eugeneworldwide/rampage_navigation_controller/Images/Additional Images/1650273794361.jpg

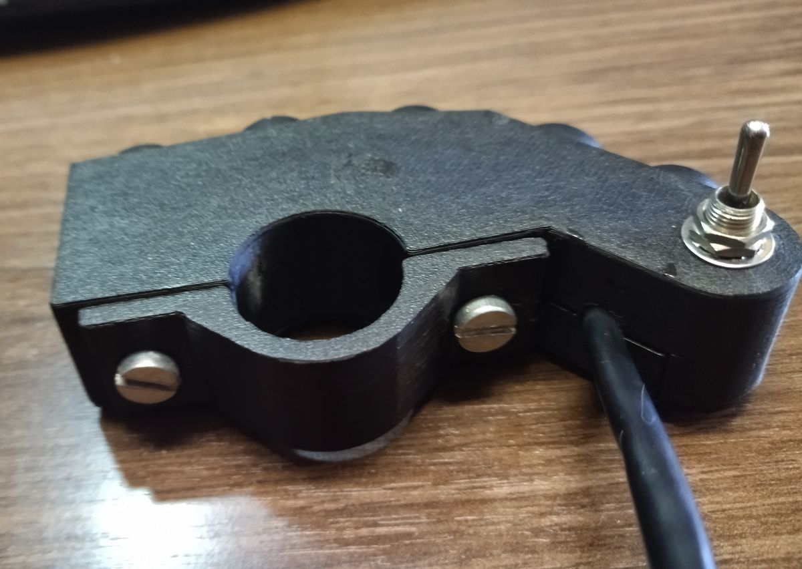
Images/Additional Images/1650273794361.jpg
