eugeneworldwide/rampage_navigation_controller/3D Print files/Bluetooth Controller v1.3 ORIGINAL SOLID DESIGN/Box Design.pdf

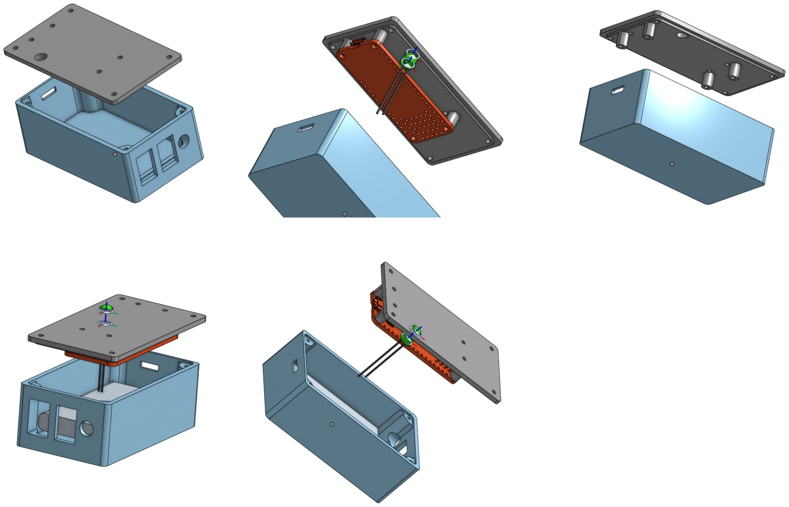
[picture p3: page 1]
