eugeneworldwide/rampage_navigation_controller/3D Print files/Bluetooth Controller v1.3 ORIGINAL SOLID DESIGN/Button Design.pdf

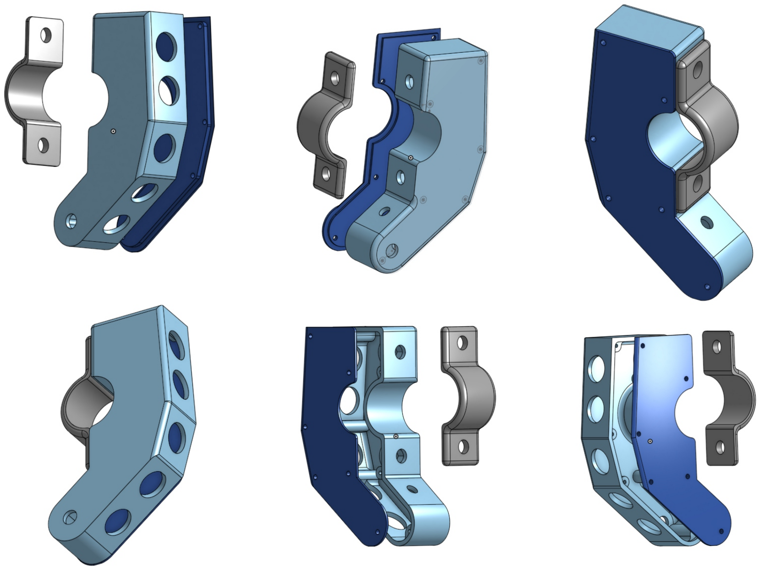
[picture p4: page 1]
