eugeneworldwide/rampage_navigation_controller/Circuit Design with 3 power options/01 Rampage Nav Circuit Design with battery.jpg

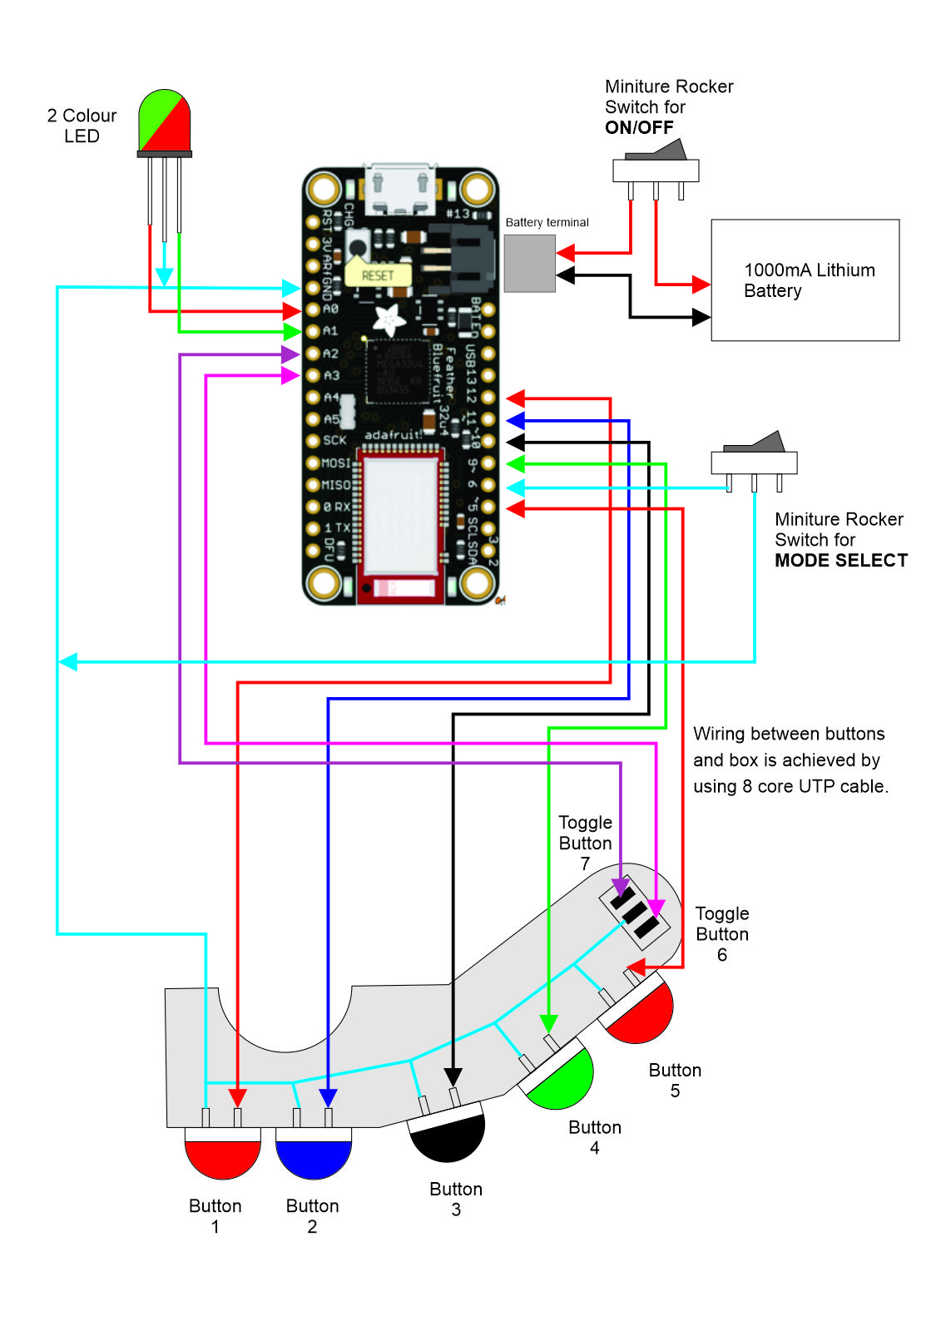
Circuit Design with 3 power options/01 Rampage Nav Circuit Design with battery.jpg
