eugeneworldwide/rampage_navigation_controller/Circuit Design with 3 power options/02 Rampage Nav Circuit Design with permanant power & battery backup.jpg

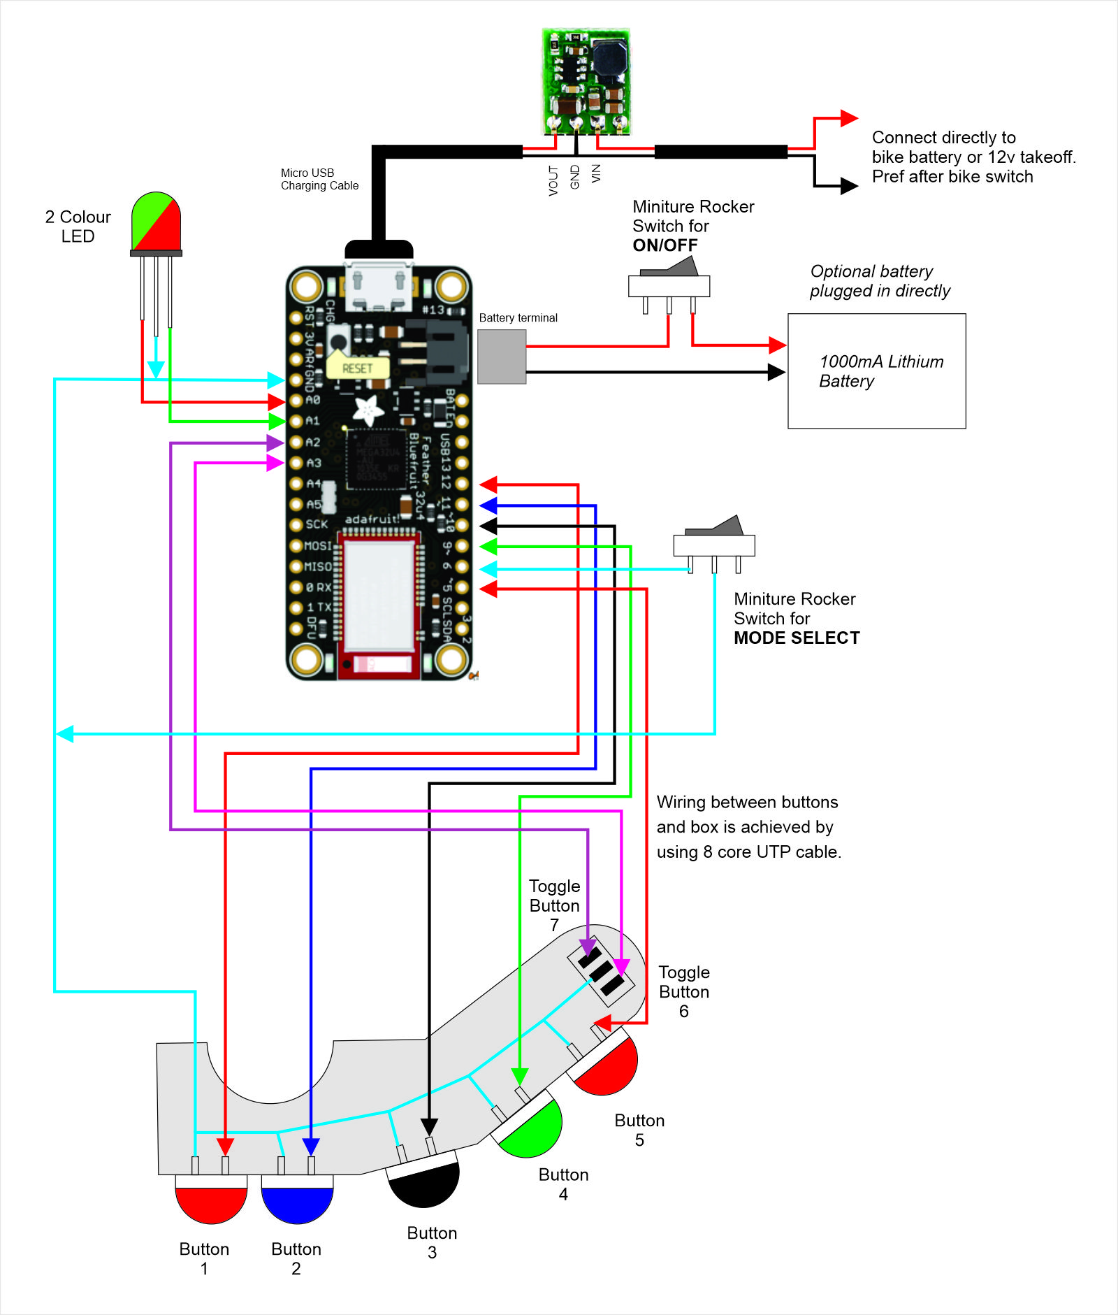
Circuit Design with 3 power options/02 Rampage Nav Circuit Design with permanant power & battery backup.jpg
