eugeneworldwide/rampage_navigation_controller/Circuit Design with 3 power options/03 Rampage Nav Circuit Design with permanant power.jpg

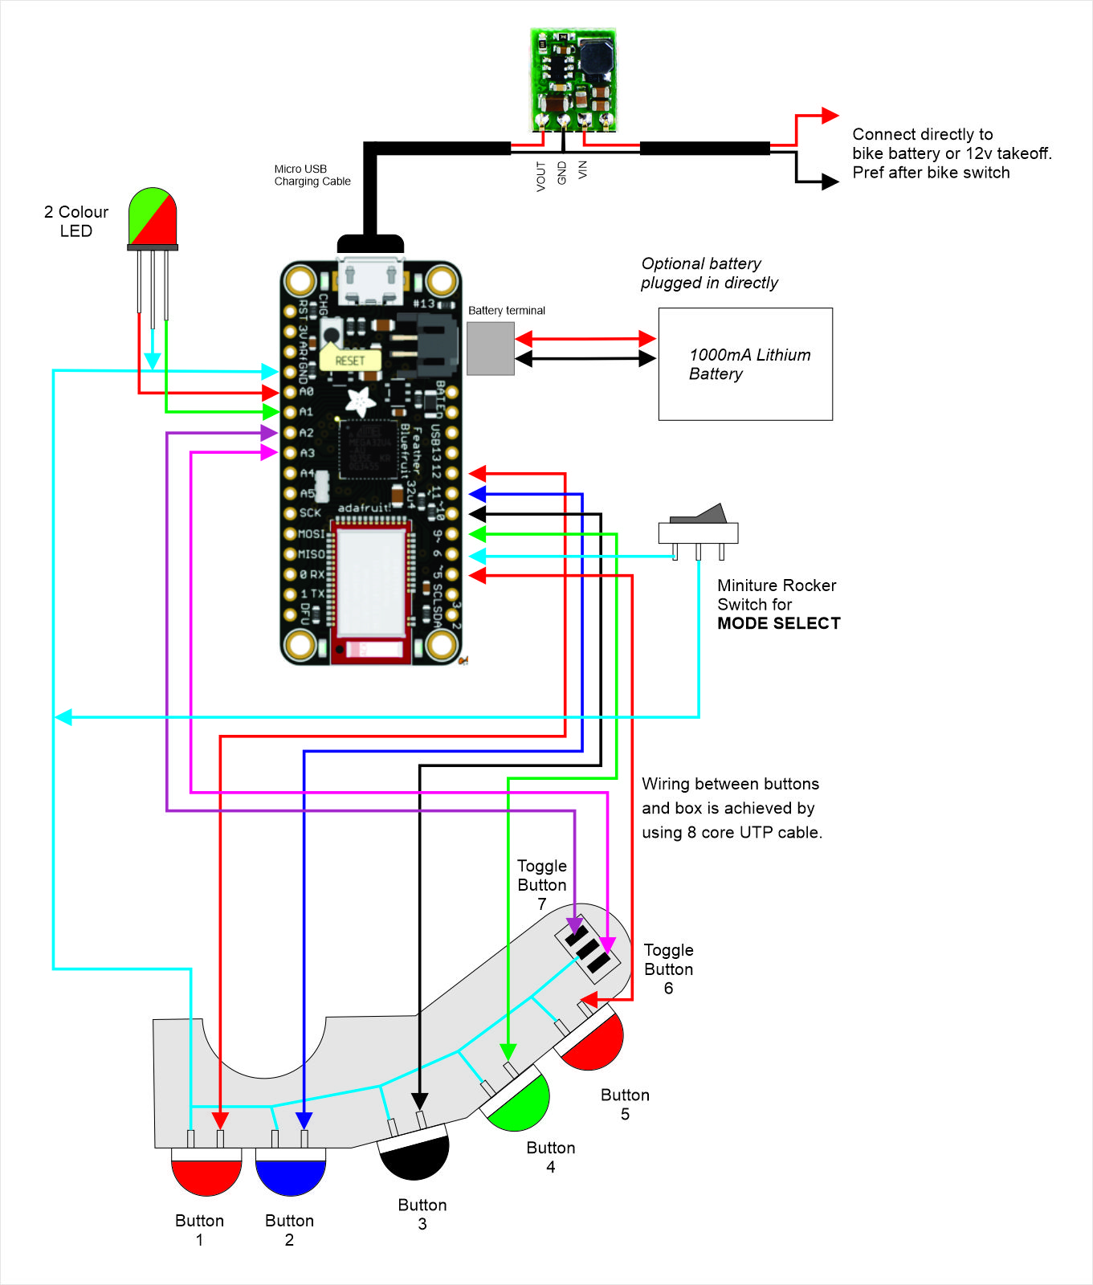
Circuit Design with 3 power options/03 Rampage Nav Circuit Design with permanant power.jpg
