eugeneworldwide/rampage_navigation_controller/Images/Additional Images/1650273722091.jpg

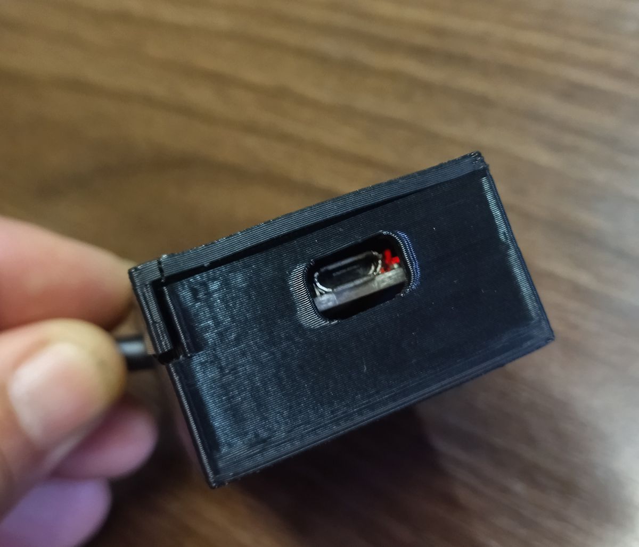
Images/Additional Images/1650273722091.jpg
