eugeneworldwide/rampage_navigation_controller/Images/Additional Images/1650273722116.jpg

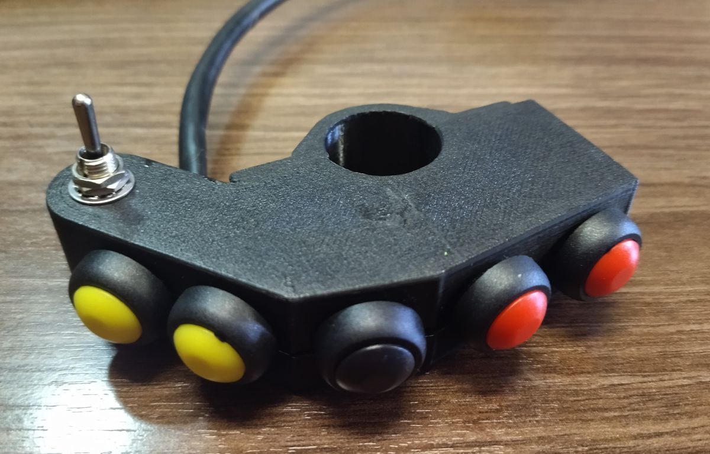
Images/Additional Images/1650273722116.jpg
