eugeneworldwide/rampage_navigation_controller/Images/Additional Images/1650274563497.jpg

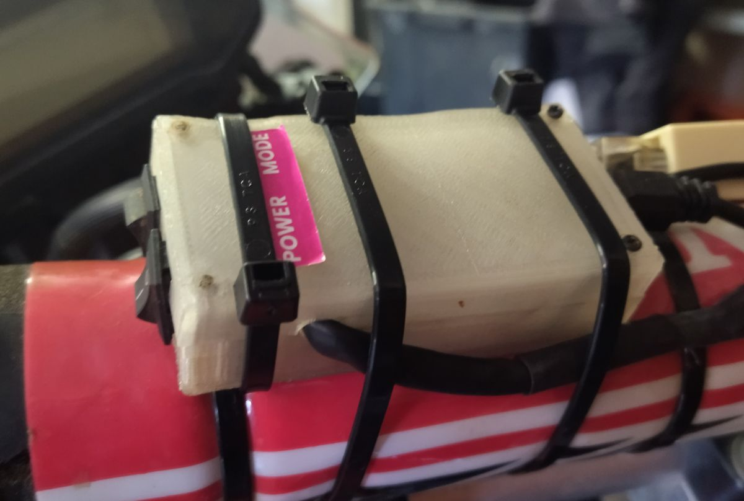
Images/Additional Images/1650274563497.jpg
