eugeneworldwide/rampage_navigation_controller/Images/Additional Images/1650274563515.jpg

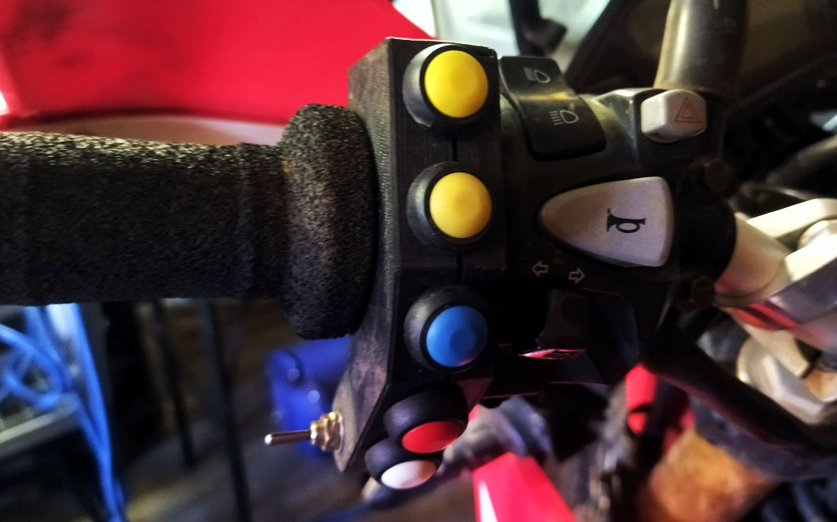
Images/Additional Images/1650274563515.jpg
