eugeneworldwide/rampage_navigation_controller/Images/Additional Images/1650276003125.jpg

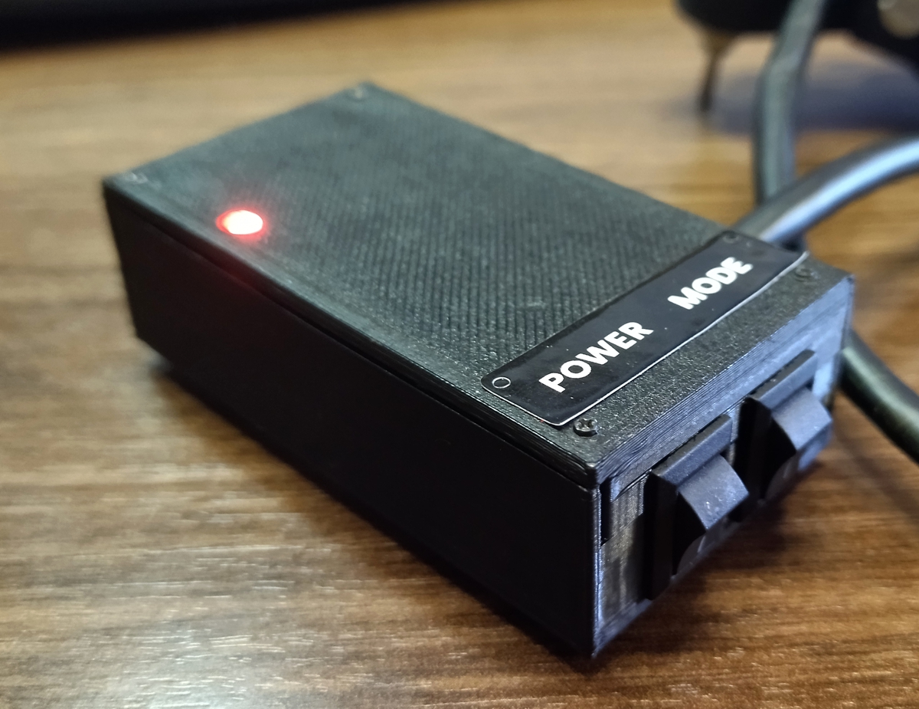
Images/Additional Images/1650276003125.jpg
