eugeneworldwide/rampage_navigation_controller/Images/Additional Images/1650276341316.jpg

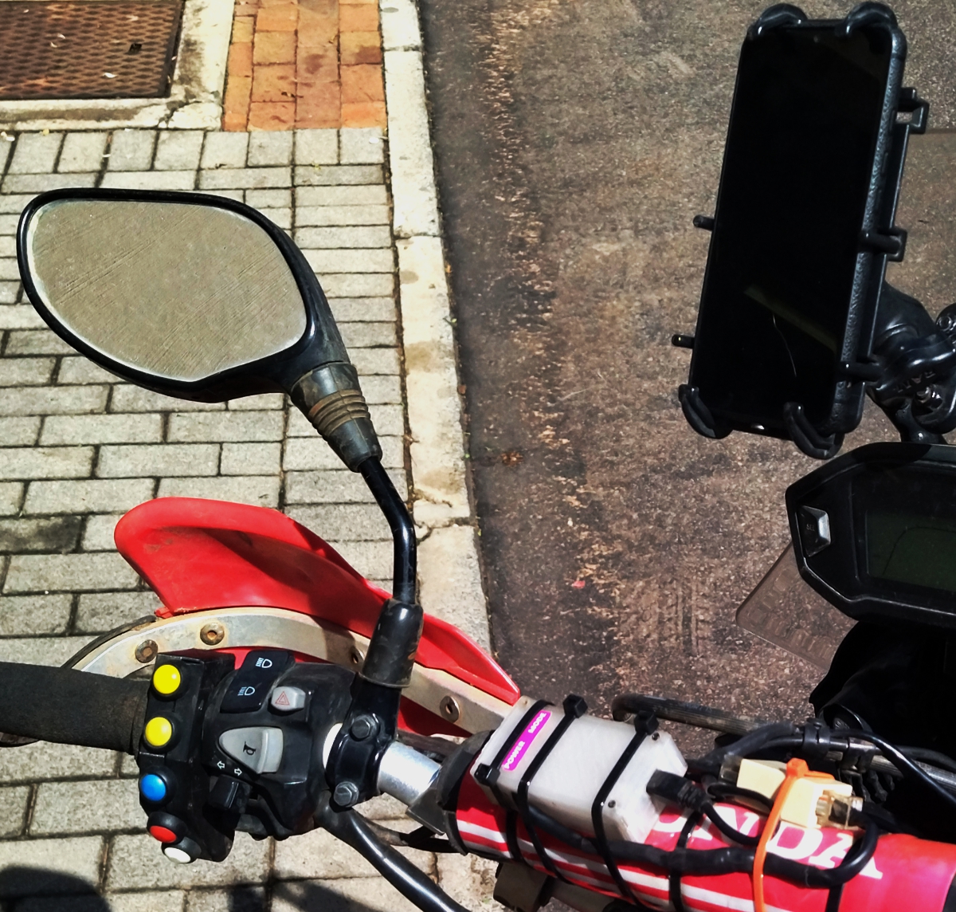
Images/Additional Images/1650276341316.jpg
