eugeneworldwide/rampage_navigation_controller/Images/Additional Images/1650276341331.jpg

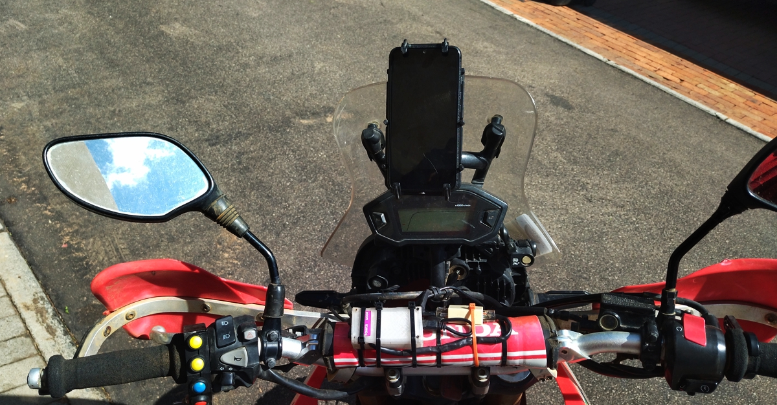
Images/Additional Images/1650276341331.jpg
