eugeneworldwide/rampage_navigation_controller/Images/Illustration Images/WhatsApp Image 2021-06-27 at 16.28.02 (5).jpeg

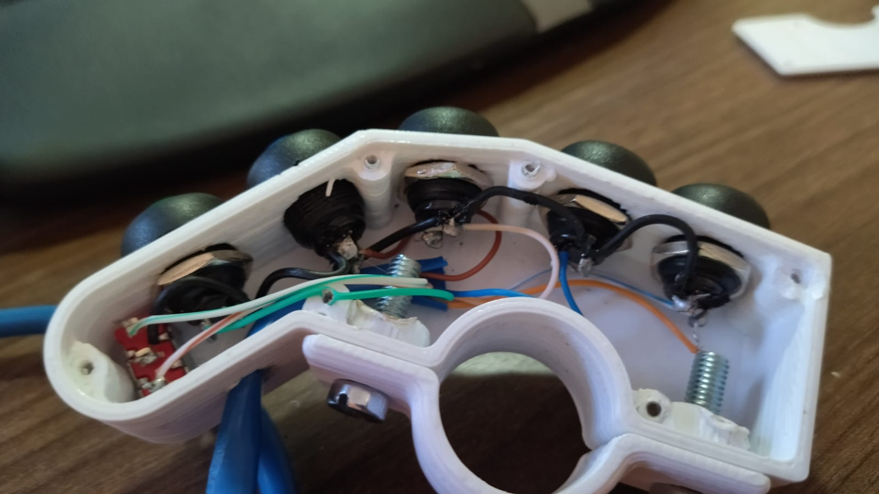
Images/Illustration Images/WhatsApp Image 2021-06-27 at 16.28.02 (5).jpeg
