eugeneworldwide/rampage_navigation_controller/Components List/Controller Component List v1.5.pdf

# What do you need to build this unit?

You will need to do and get the following:
- some electronic components to build your bluetooth board with buttons.
- A 3D printer to print the controller and housing.
- Soldering and electronic assembly with wires.
- Upload code onto your board using the Arduino IDE.
- Common sense…lol.. No seriously, you will need to think practically.

# Components List

For this project you will need the following components:

© Rally Rampage 2021 - www.rallyrampage.com | Page 3 of 15
Made available under GNU Affero General Public License v3.0
# | Component | Qty | Online link of product and example

1 | Adafruit 32u4 Bluefruit Board | 1 | https://www.robotics.org.za/AF2829
2 | Mini Switch 12mm Waterproof | 6 | https://www.robotics.org.za/PBS-33B
3 | Rocker Switch | 2 | https://www.robotics.org.za/KCD11
4 | Toggle switch - center return | 1 | https://www.communica.co.za/products/m2019ss1w 01 (https://www.communica.co.za/products/m2019ss1w01)
5 | UTP Cable | 1 | Any 8 core UTP cable to use between your switches and your bluetooth box
6 | Wires | 1 | Additional wire to connect between switches and common joints
7 | 2 Colour LED | 1 | https://www.robotics.org.za/RG5-10
8 | M2 Screws | 10 | Miniature screws to attached lids
9 | 1000mA battery (FOR OPTION 1 DESIGN) | 1 | https://www.robotics.org.za/DTP603450?search=100 0ma (https://www.robotics.org.za/DTP603450?search=1000ma) Battery to use for power if not permanently powered
10 | 5v Step down regulator (For OPTION 2 design) | 1 | https://www.robotics.org.za/3792 Used for permanent power on your unit to use your vehicle's 12v perm source.
11 | Micro USB Charging Cable (For OPTION 2 design) | 1 | To be used for the regulator and cut up for perm power OPTION 2
