eugeneworldwide/rampage_navigation_controller/3D Print files/Bluetooth Controller v1.3 ORIGINAL SOLID DESIGN/STL Files/Controller buttons 1.2.1 Solid one side - Casing.stl

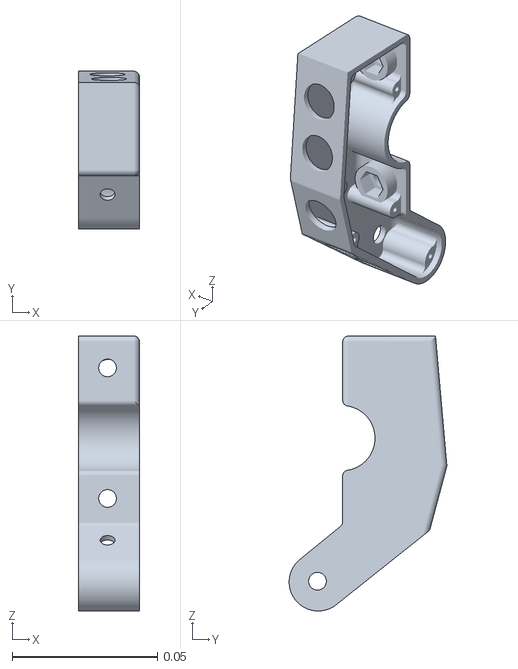
[picture p33: CAD file, 2021-06-27]
3D Print files/Bluetooth Controller v1.3 ORIGINAL SOLID DESIGN/STL Files/Controller buttons 1.2.1 Solid one side - Casing.stl
0.021 x 0.0544 x 0.0948
