eugeneworldwide/rampage_navigation_controller/3D Print files/Bluetooth Controller v1.3 ORIGINAL SOLID DESIGN/STL Files/Controller buttons 1.2.1 Solid one side - Back plate.stl

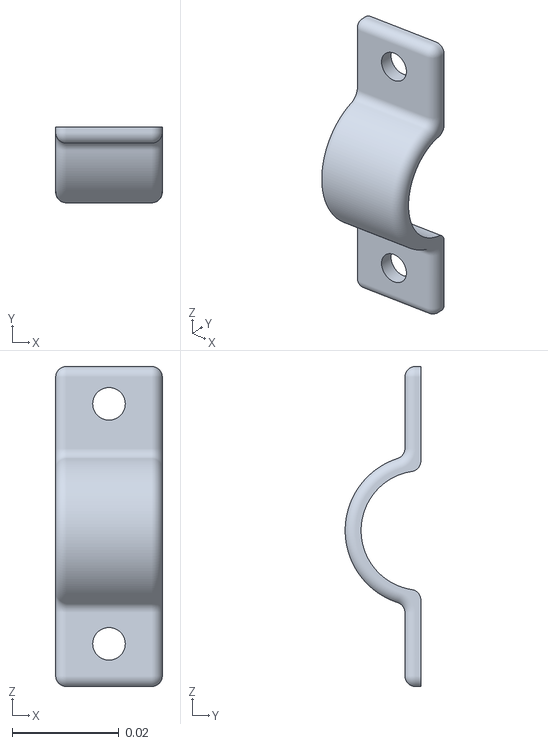
[picture p35: CAD file, 2021-06-27]
3D Print files/Bluetooth Controller v1.3 ORIGINAL SOLID DESIGN/STL Files/Controller buttons 1.2.1 Solid one side - Back plate.stl
0.02 x 0.0142 x 0.06
