eugeneworldwide/rampage_navigation_controller/3D Print files/Bluetooth Controller v1.6 TWO SIDED OPTION FOR EASIER SOLDERING/STL Files 1.6 (Correct Confirmed)/Controller button 1.6 - Lid.stl

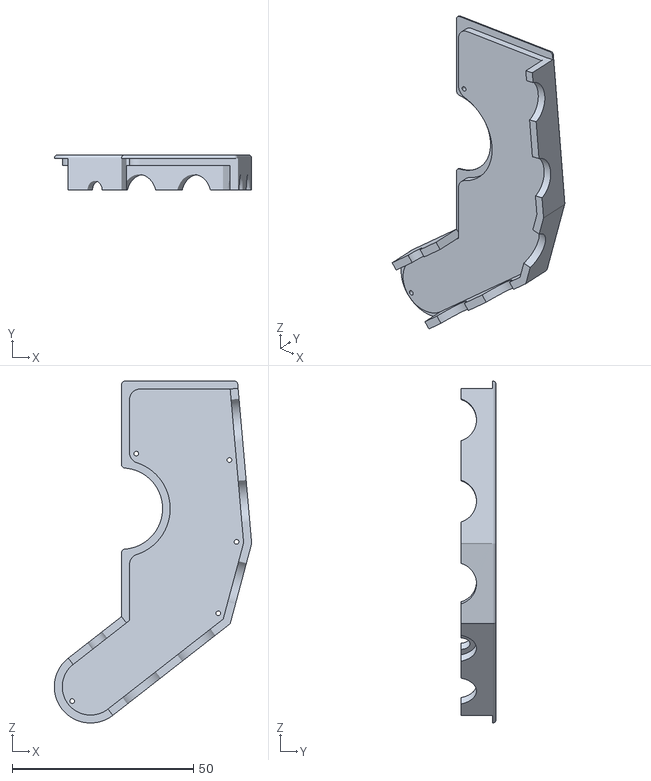
[picture p36: CAD file, 2023-06-27]
3D Print files/Bluetooth Controller v1.6 TWO SIDED OPTION FOR EASIER SOLDERING/STL Files 1.6 (Correct Confirmed)/Controller button 1.6 - Lid.stl
54.5 x 9.78 x 94.3
