eugeneworldwide/rampage_navigation_controller/3D Print files/Bluetooth Controller v1.3 ORIGINAL SOLID DESIGN/STL Files/Controller buttons 1.2.1 Solid one side - lid.stl

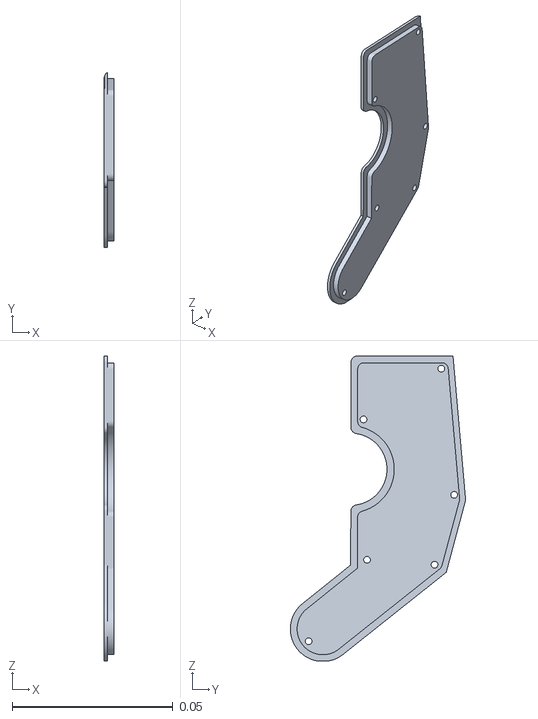
[picture p37: CAD file, 2021-06-27]
3D Print files/Bluetooth Controller v1.3 ORIGINAL SOLID DESIGN/STL Files/Controller buttons 1.2.1 Solid one side - lid.stl
0.003 x 0.0545 x 0.0948
