eugeneworldwide/rampage_navigation_controller/3D Print files/Bluetooth Controller v1.6 TWO SIDED OPTION FOR EASIER SOLDERING/STL Files 1.6 (Correct Confirmed)/Controller button 1.6 - Back.stl

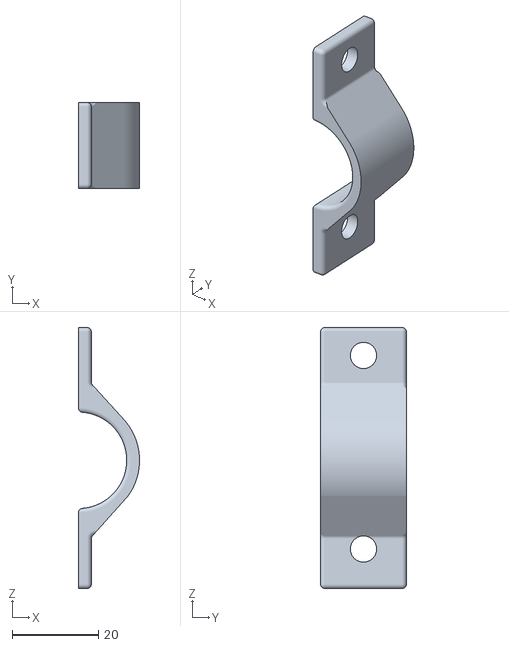
[picture p38: CAD file, 2021-10-21]
3D Print files/Bluetooth Controller v1.6 TWO SIDED OPTION FOR EASIER SOLDERING/STL Files 1.6 (Correct Confirmed)/Controller button 1.6 - Back.stl
14.2 x 20.0 x 60.7
