eugeneworldwide/rampage_navigation_controller/3D Print files/Bluetooth Controller v1.6 TWO SIDED OPTION FOR EASIER SOLDERING/STL Files 1.6 (Correct Confirmed)/Bluetooth box 1.6 - Box.stl

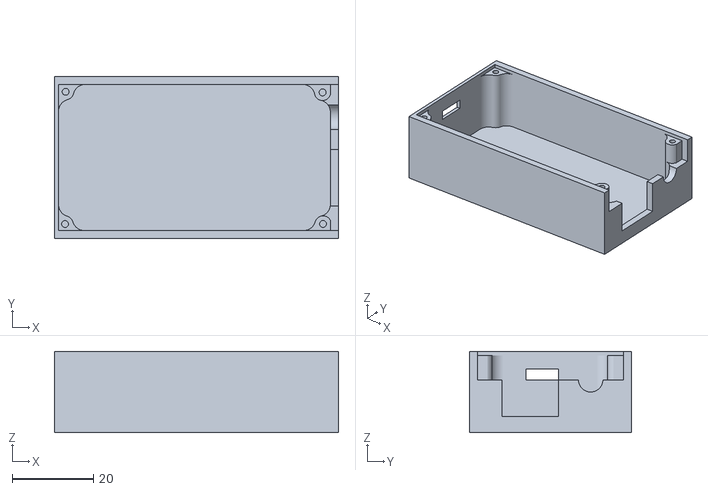
[picture p40: CAD file, 2021-10-13]
3D Print files/Bluetooth Controller v1.6 TWO SIDED OPTION FOR EASIER SOLDERING/STL Files 1.6 (Correct Confirmed)/Bluetooth box 1.6 - Box.stl
70.0 x 40.0 x 20.0
