eugeneworldwide/rampage_navigation_controller/3D Print files/Bluetooth Controller v1.3 ORIGINAL SOLID DESIGN/STL Files/Bluetooth box 1.1 - Box.stl

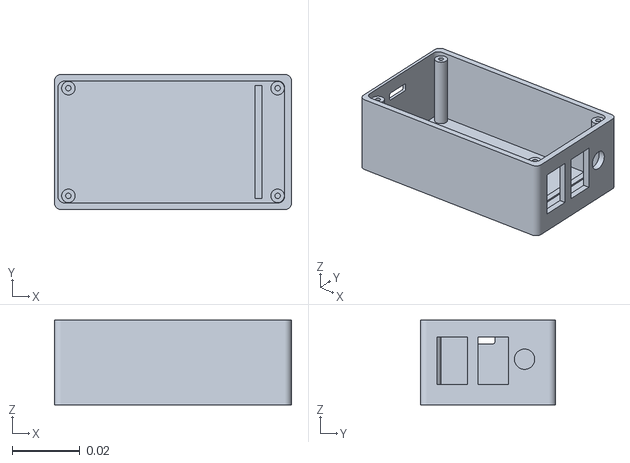
[picture p41: CAD file, 2021-06-27]
3D Print files/Bluetooth Controller v1.3 ORIGINAL SOLID DESIGN/STL Files/Bluetooth box 1.1 - Box.stl
0.07 x 0.04 x 0.025
