eugeneworldwide/rampage_navigation_controller/Assembly Instructions/Rally Rampage Bluetooth Navigator Instructions v1.7 OPEN SOURCE .pdf

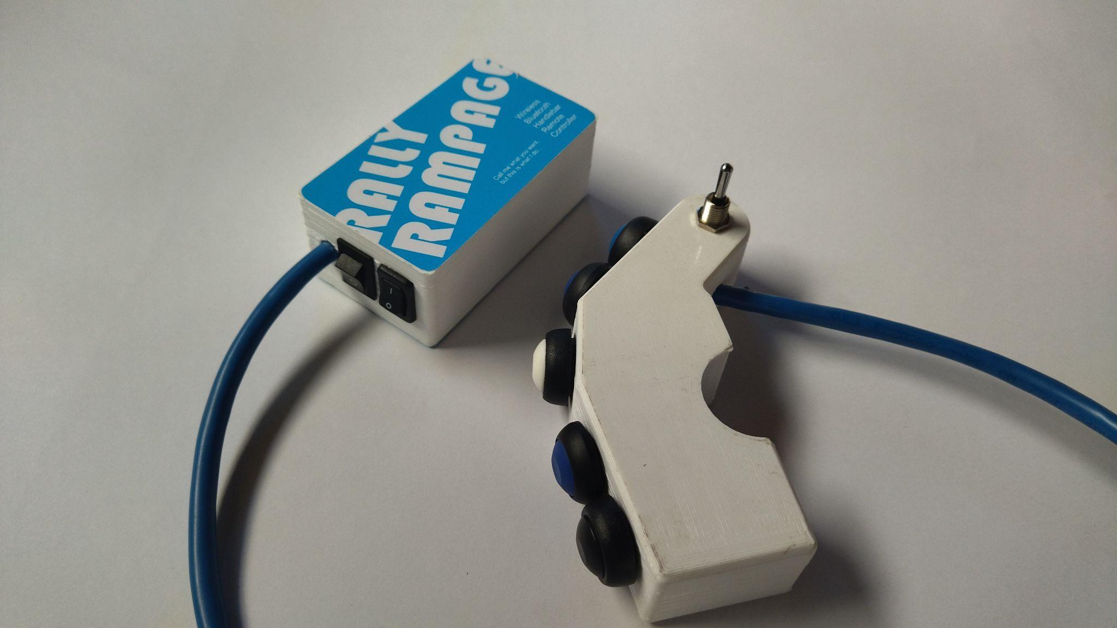
[picture p43: figure]

# Welcome to our

# Rampage Navigator

# Project!

Version 1.7
Updated: 20211214

This document is the explanation and instructions to assemble your own device. In the design and making of the unit, we have kept in mind the use of over-the-counter products. This will play a role in helping you source any exact components or similar components for your project.

What's included in these instructions:
- Components list
- 3D print model files
- Stickers for your little unit
- Some instructions on assembly
- Arduino IDE code for your Adafruit 32u4 board

# So let's get started!

© Rally Rampage 2021 - www.rallyrampage.com | Page 1 of 18
Made available under GNU Affero General Public License v3.0

So let's get started! | 1
What do you need to build this unit? | 3
Components List | 3
Tools | 4
Adafruit Board Default Layout | 5
The Rampage Nav Circuit Design | 6
Notes on circuit assembly | 7
Instructions | 8
Arduino IDE Sketch Explanation | 10
Final testing | 11
Suggestions | 11
Final thoughts | 12
Open Source License - Conditions | 13
GITHUB | 13
© Rally Rampage 2021 - www.rallyrampage.com | Page 2 of 18

## What do you need to build this unit?

You will need to do and get the following:
- some electronic components to build your bluetooth board with buttons.
- A 3D printer to print the controller and housing.
- Soldering and electronic assembly with wires.
- Upload code onto your board using the Arduino IDE.
- Common sense…lol.. No seriously, you will need to think practically.

## Components List

For this project you will need the following components:

# | Component | Qty | Online link of product and example

1 | Adafruit 32u4 Bluefruit Board | 1 | https://www.robotics.org.za/AF2829
2 | Mini Switch 12mm Waterproof | 6 | https://www.robotics.org.za/PBS-33B
3 | Rocker Switch | 2 | https://www.robotics.org.za/KCD11
4 | Toggle switch - center return | 1 | https://www.communica.co.za/products/m2019ss1w0 1 (https://www.communica.co.za/products/m2019ss1w01)
5 | UTP Cable | 1 | Any 8 core UTP cable to use between your switches and your bluetooth box
6 | Wires | 1 | Additional wire to connect between switches and common joints
7 | 2 Colour LED | 1 | https://www.robotics.org.za/RG5-10
8 | M2 Screws | 10 | Miniature screws to attached lids
9 | 1000mA battery (FOR OPTION 1 DESIGN) | 1 | https://www.robotics.org.za/DTP603450?search=100 0ma (https://www.robotics.org.za/DTP603450?search=1000ma) Battery to use for power if not permanently powered
10 | 5v Step down regulator (For OPTION 2 design) | 1 | https://www.robotics.org.za/3792 Used for permanent power on your unit to use your vehicle's 12v perm source.
11 | Micro USB Charging Cable (For OPTION 2 design) | 1 | To be used for the regulator and cut up for perm power OPTION 2
© Rally Rampage 2021 - www.rallyrampage.com | Page 3 of 18

## Tools

You will need the following minimum tools to build this device:
- Soldering iron and solder
- Wire cutters
- Wire stripper
- Computer with Arduino IDE installed
© Rally Rampage 2021 - www.rallyrampage.com | Page 4 of 18

## Adafruit Board Default Layout

The default PIN layout for this Adafruit board is as follows:

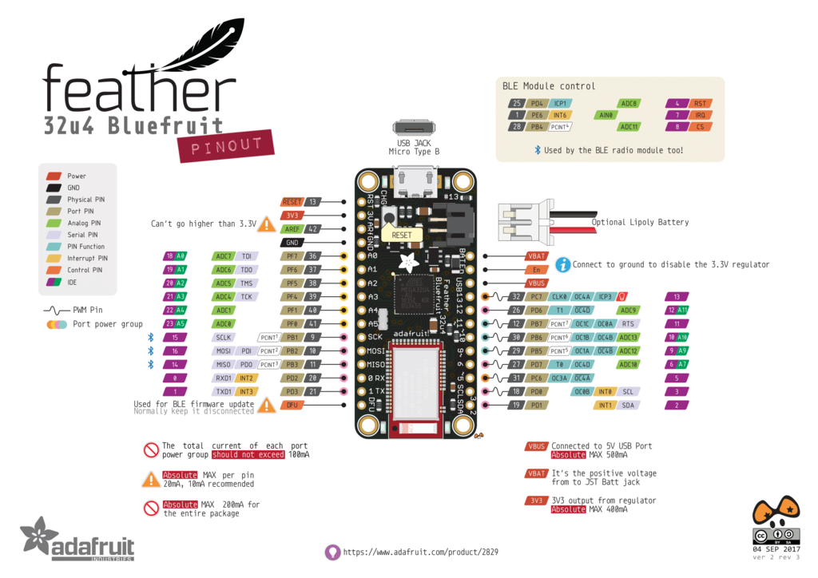
[picture p44: figure]

For more information about this board and how to set it up click this link: https://learn.adafruit.com/adafruit-feather-32u4-bluefruit-le?view=all

© Rally Rampage 2021 - www.rallyrampage.com | Page 5 of 18

## DESIGNS OPTION1: The Rampage Nav Circuit Design with Li Battery

The circuit design and buttons we are using are the following:

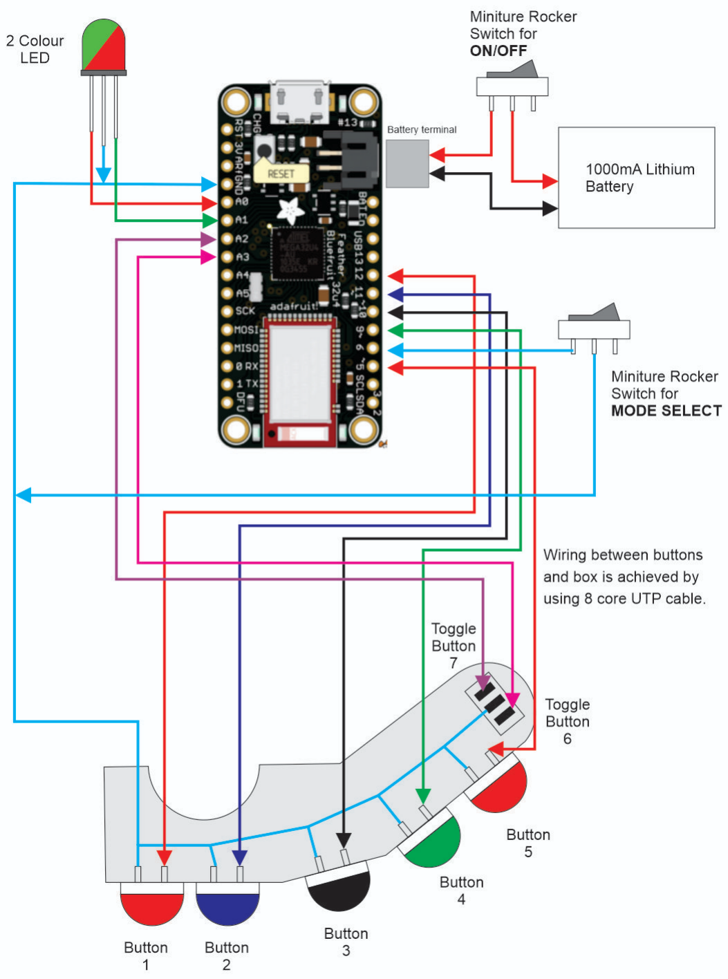
[picture p45: figure]

© Rally Rampage 2021 - www.rallyrampage.com | Page 6 of 18

### Notes on circuit assembly for Option 1

- The ground (GND) will need to go to all the buttons, one rocker switch and the central LED PIN.
- The LED PINs are close enough to just bend and solder directly into the board.
- The main mode LED must stick through the larger hole in the box.
- The battery lies at the bottom of the bluetooth box.
- Wiring between buttons and box is achieved by using 8 core UTP cable.
© Rally Rampage 2021 - www.rallyrampage.com | Page 7 of 18

## DESIGNS OPTION 2: The Rampage Nav Circuit Design with permanent power from 12v vehicle

The circuit design and buttons we are using are the following:

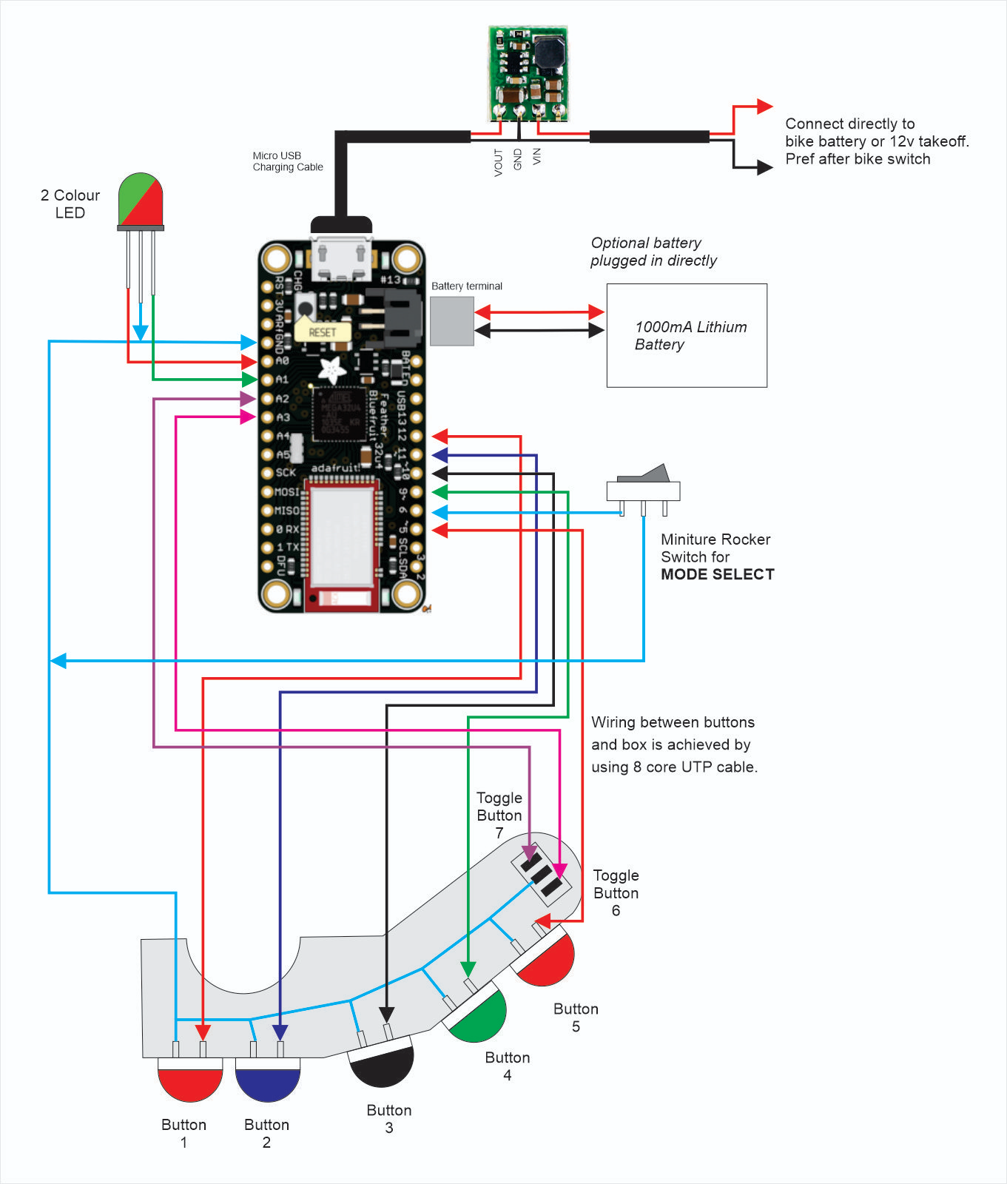
[picture p46: figure]

© Rally Rampage 2021 - www.rallyrampage.com | Page 8 of 18

### Notes on circuit assembly for Option 2:

- The ground (GND) will need to go to all the buttons, one rocker switch and the central LED PIN.
- The LED PINs are close enough to just bend and solder directly into the board.
- The main mode LED must stick through the larger hole in the box.
- The battery lies at the bottom of the bluetooth box.
- Wiring between buttons and box is achieved by using 8 core UTP cable.
- For the perm power use an existing USB charging cable and simply solder the 5v regulator in the middle of the cable. Use the micro USB in your unit and cut off the larger USB as you will need positive and negative directly.
© Rally Rampage 2021 - www.rallyrampage.com | Page 9 of 18

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
v3.0

## DESIGNS OPTION 3: The Rampage Nav Circuit Design with permanent power from 12v vehicle & battery backup

The circuit design and buttons we are using are the following:

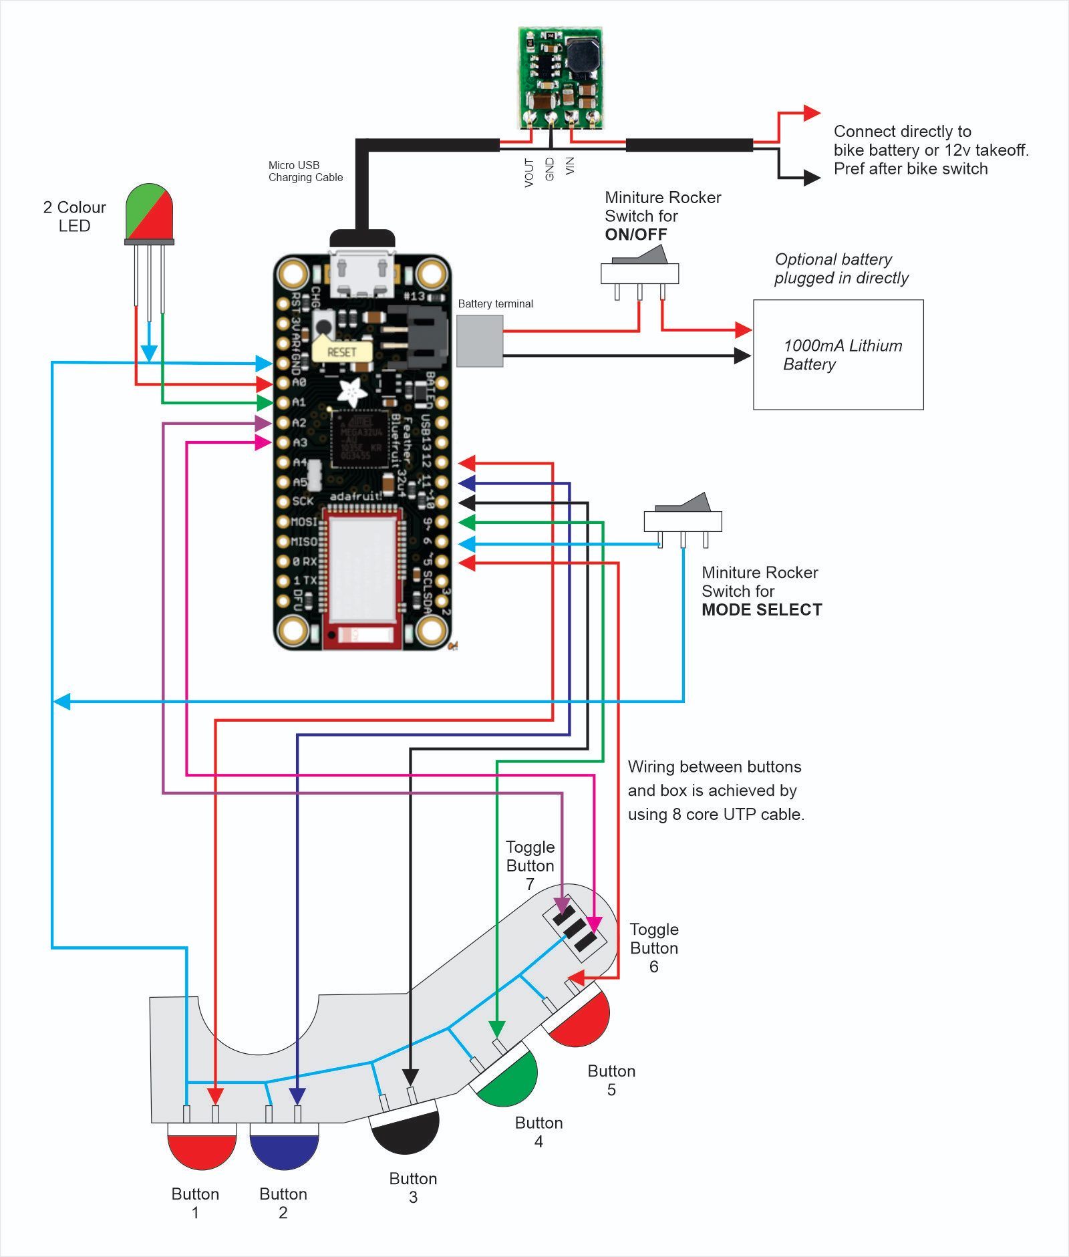
[picture p47: figure]

© Rally Rampage 2021 - www.rallyrampage.com | Page 11 of 18

### Notes on circuit assembly for Option 3:

- The ground (GND) will need to go to all the buttons, one rocker switch and the central LED PIN.
- The LED PINs are close enough to just bend and solder directly into the board.
- The main mode LED must stick through the larger hole in the box.
- The battery lies at the bottom of the bluetooth box.
- Wiring between buttons and box is achieved by using 8 core UTP cable.
- For the perm power use an existing USB charging cable and simply solder the 5v regulator in the middle of the cable. Use the micro USB in your unit and cut off the larger USB as you will need positive and negative directly.
- The rocker switch on the battery will put the battery in the circuit so the board can either run off the battery. Or if permanent power is is on and the battery is turned on, it will automatically charge and act as backup if main power goes off.
© Rally Rampage 2021 - www.rallyrampage.com | Page 12 of 18

## Instructions

Please remember this is a DIY project. You will need to have some understanding of electronics, soldering, assembly and Arduino IDE coding.

As far as I could I have made note of anything that would help you in building your buttons.

### 1. Preparation

a. Buy all components.
b. Prepare soldering and electronics tools for assembly.
c. Install and set up Arduino IDE on your computer to flash the Adafruit board with the code.
d. Cut the UTP cable in approx 30cm length. The one side will go into the button controller and the other will go into the bluetooth housing.

### 2. Boxes

a. Print the 3D files to create your button controller and the bluetooth housing box.
b. You must end up with the button controller housing as well as the bluetooth board housing.

### 3. Buttons

a. Install the 5 push buttons into the 3D printed housing.
b. Insert the toggle switch into the button housing.
c. Insert the rocker switches into the bluetooth housing.

### 4. Soldering

a. Solder the UTP cable between the button controller and the bluetooth. housing. Making sure you solder the correct colour code of the UTP cable wire to the buttons and the pin on the Adafruit board as indicated in the above drawing of the board and its PINs.

### 5. Coding your board

a. Setup your Arduino IDE interface as per these instruction from Adafruit themselves
https://learn.adafruit.com/adafruit-feather-32u4-bluefruit-le/setup
b. Once setup, you can open the Rampage Navigator sketch on your computer
c. I would suggest just Compiling the script to make it all fine.
© Rally Rampage 2021 - www.rallyrampage.com | Page 13 of 18

d. You can upload the script to your board.
e. Start testing buttons using your serial monitor from the IDE

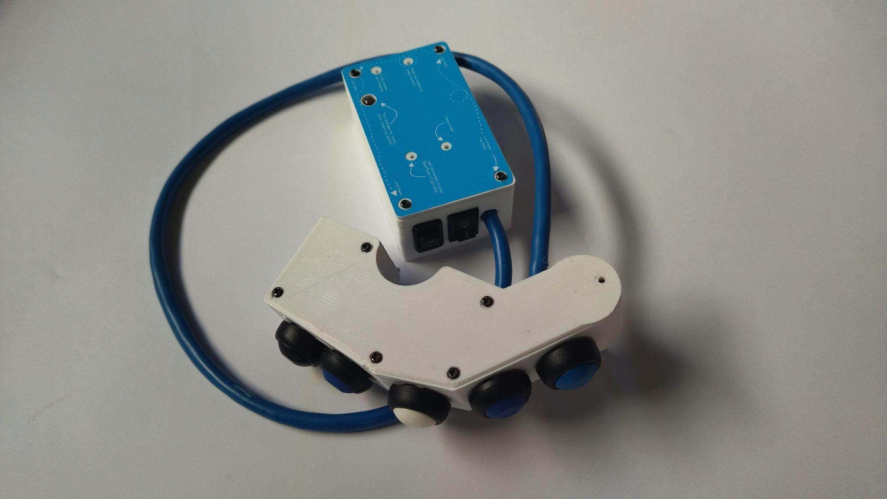
[picture p48: figure]

© Rally Rampage 2021 - www.rallyrampage.com | Page 14 of 18

## Arduino IDE Sketch 1.7 Explanation

- The 1.7 sketch is a complete new code design and changes the use of the mode rocker switch completely.
- On the new code, the one rocker switch acts as mains power from the battery.
- The other rocker switches the unit between App Use and App Select modes.
- In App Use, the buttons will have been assigned according to the softApp selected in the other mode. The unit now can have mapping of up to 5 different Android apps.
- In App Select, you can select which softApp the unit must send command to.
- The App select mode you can select an app by pressing one of the 5 controller buttons to select softApp 1-5. After clicking the button, the main LED will flicker the amount of times 1-5 to confirm selection. You can then simply switch the rocker back to App mode and that app will now be used.
© Rally Rampage 2021 - www.rallyrampage.com | Page 15 of 18

### Final testing

- Once all your buttons are active and sending commands you are ready to test on your phone.
- Turn your phone’s bluetooth on.
- Select the Rally Navigator bluetooth device that should be visible now.
- Once it pairs between the devices, you should hear what I call the ‘happy sound’ to show the device is seen as a keyboard for the phone.
- To test this pairing, select your phone's HOME button. Press the top controller button which is supposed to increase the phone's volume. If you see the phones volume goes up, it works.
- Make sure which mode your phone is on by looking at the two color LEDs. One colour will represent one mode, the other colour will represent the other mode.
- If you have used my normal sketch for your buttons, Mode 1 will have the functions for Locus Maps and the other Mode should work with media.

## Suggestions

1. You can assemble the electronics first using a non-soldering breadboard (https://www.robotics.org.za/NE00352).
a. This works great to learn and understand the workings, code and layout.
© Rally Rampage 2021 - www.rallyrampage.com | Page 16 of 18

## Final thoughts

This is an open-source project to allow other parties to contribute to the code, design and project.

If you make improvements, please forward them back to us so we can eventually launch it publicly on our website.

Thanks for your involvement.

Eugene Beetge
info@rallyrampage.com
South Africa

## GITHUB

This project is also available on GitHub at: https://github.com/eugeneworldwide/rampage_navigation_controller

© Rally Rampage 2021 - www.rallyrampage.com | Page 17 of 18

## Open Source License - Conditions

This project is offered under the GNU Affero General Public License v3.0 The content of the license text is available at: https://www.gnu.org/licenses/

© Rally Rampage 2021 - www.rallyrampage.com | Page 18 of 18
