eugeneworldwide/rampage_navigation_controller/3D Print files/Bluetooth Controller v1.6 TWO SIDED OPTION FOR EASIER SOLDERING/Bluetooth Box 1.6.pdf

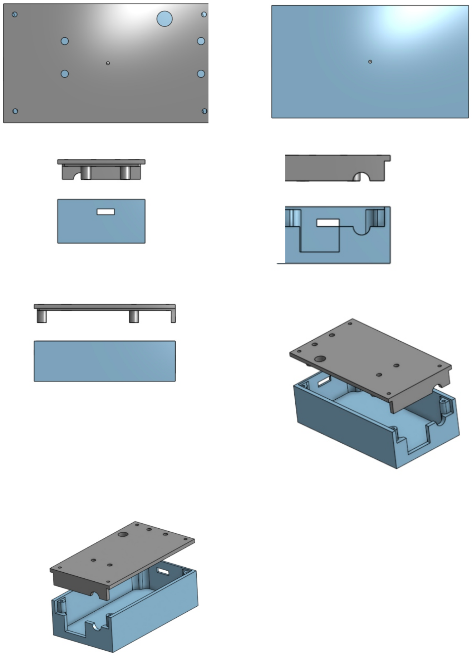
[picture p60: page 1]
