eugeneworldwide/rampage_navigation_controller/3D Print files/Bluetooth Controller v1.6 TWO SIDED OPTION FOR EASIER SOLDERING/Bluetooth Buttons 1.6.pdf

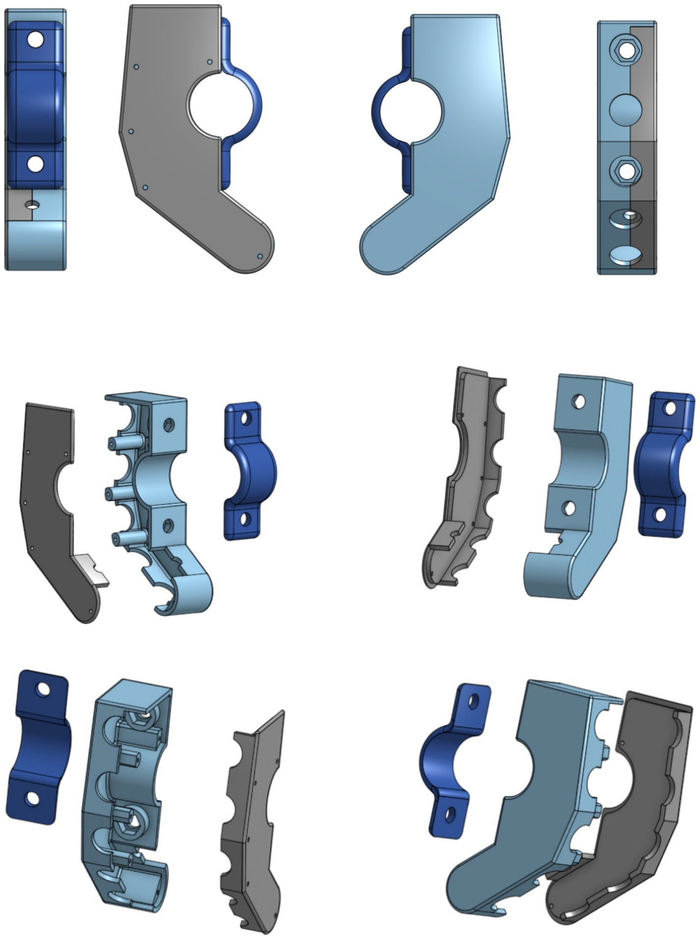
[picture p61: page 1]
