eugeneworldwide/rampage_navigation_controller/(threads)

Thread 1 (2021-09-25):

Battery missing from Components List

r-e-l-z, 2021-09-25:
The 1000mah battery appears in the pictures, and is also mentioned in the circuit design.
Perhaps add it to the Component List in the Instructions pdf too?

eugeneworldwide, 2021-09-27:
Thanks. I updated the files accordingly and included the permanent power option also

Closed 2021-09-29.

Thread 6 (2024-06-01):

3d Model Files (Fusion360 or similar)

Bischi1997, 2024-06-01:
Hey,
after checking the PDF as well as this repo, is there a possibility to also upload the original model files (Fusion360 or similar) to update the 3d design?
Best regards
Bischi

eugeneworldwide, 2024-06-03:
Hi Bischi,

I can do that. I use OnShape online for our designs but can export into a
format that works. Let me know any version or so that will work for you.

We are doing quite a lot of new stuff on the new model coming out.
Different board, form factors etc.

*Eugene*

082 659 3035

***@***.*** ***@***.***>*

[image: A picture containing clipart Description automatically generated]

*Management Tech Consulting and Hosting at its best!*

*www.disalox.co.za <http://www.disalox.co.za/>*

*From:* Bischi1997 ***@***.***>
*Sent:* Saturday, 01 June 2024 14:58
*To:* eugeneworldwide/rampage_navigation_controller <
***@***.***>
*Cc:* Subscribed ***@***.***>
*Subject:* [eugeneworldwide/rampage_navigation_controller] 3d Model Files
(Fusion360 or similar) (Issue #6)

Hey,
after checking the PDF as well as this repo, is there a possibility to also
upload the original model files (Fusion360 or similar) to update the 3d
design?
Best regards
Bischi

—
Reply to this email directly, view it on GitHub
<https://github.com/eugeneworldwide/rampage_navigation_controller/issues/6>,
or unsubscribe
<https://github.com/notifications/unsubscribe-auth/ACPXRMVXOTHRI6RODIKAMADZFHAMRAVCNFSM6AAAAABIUENWXWVHI2DSMVQWIX3LMV43ASLTON2WKOZSGMZDSMJSHEZDOMA>
.
You are receiving this because you are subscribed to this thread.Message
ID: ***@***.***>
