eugeneworldwide/rampage_navigation_controller/Assembly Instructions/Rampage Nav Buttons assignment per app - Sheet1.pdf

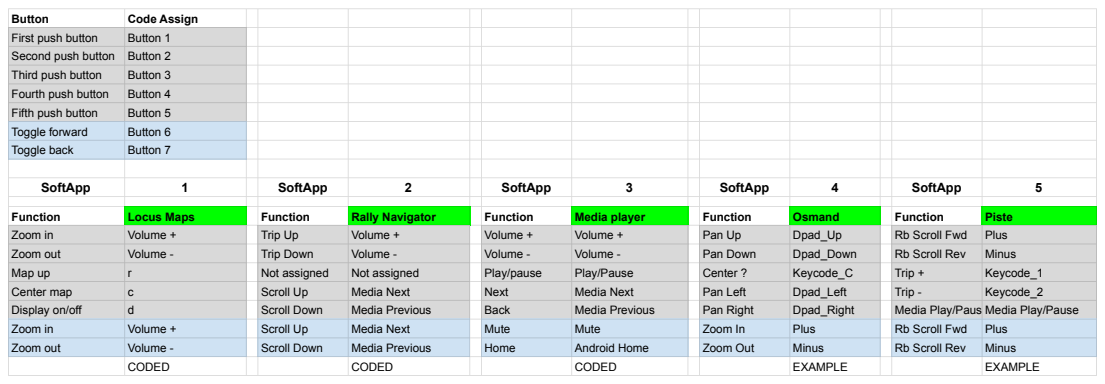
[picture p62: page 1]
Button; Code Assign; SoftApp; CODED; EXAMPLE

First push button Button 1 Second push button Button 2 Third push button Button 3 Fourth push button Button 4 Fifth push button Button 5

Toggle forward Button 6 Toggle back Button 7

Function | Locus Maps | Function | Rally Navigator | Function | Media player | Function | Osmand | Function | Piste
Zoom in Volume + Zoom out Volume -Map up r Center map c Display on/off d | | Trip Up Volume + Trip Down Volume -Not assigned Not assigned Scroll Up Media Next Scroll Down Media Previous | | Volume + Volume + Volume -Volume -Play/pause Play/Pause Next Media Next Back Media Previous | | Pan Up Dpad_Up Pan Down Dpad_Down Center ? Keycode_C Pan Left Dpad_Left Pan Right Dpad_Right | | Rb Scroll Fwd Plus Rb Scroll Rev Minus Trip + Keycode_1 Trip -Keycode_2 Media Play/PauseMedia Play/Pause

Zoom in Volume + Zoom out Volume - | | Scroll Up Media Next Scroll Down Media Previous | | Mute Mute Home Android Home | | Zoom In Plus Zoom Out Minus | | Rb Scroll Fwd Plus Rb Scroll Rev Minus
