eugeneworldwide/rampage_navigation_controller/Circuit Design with 3 power options/02 Rampage Navigator Circuit Design with permanent power & battery.pdf

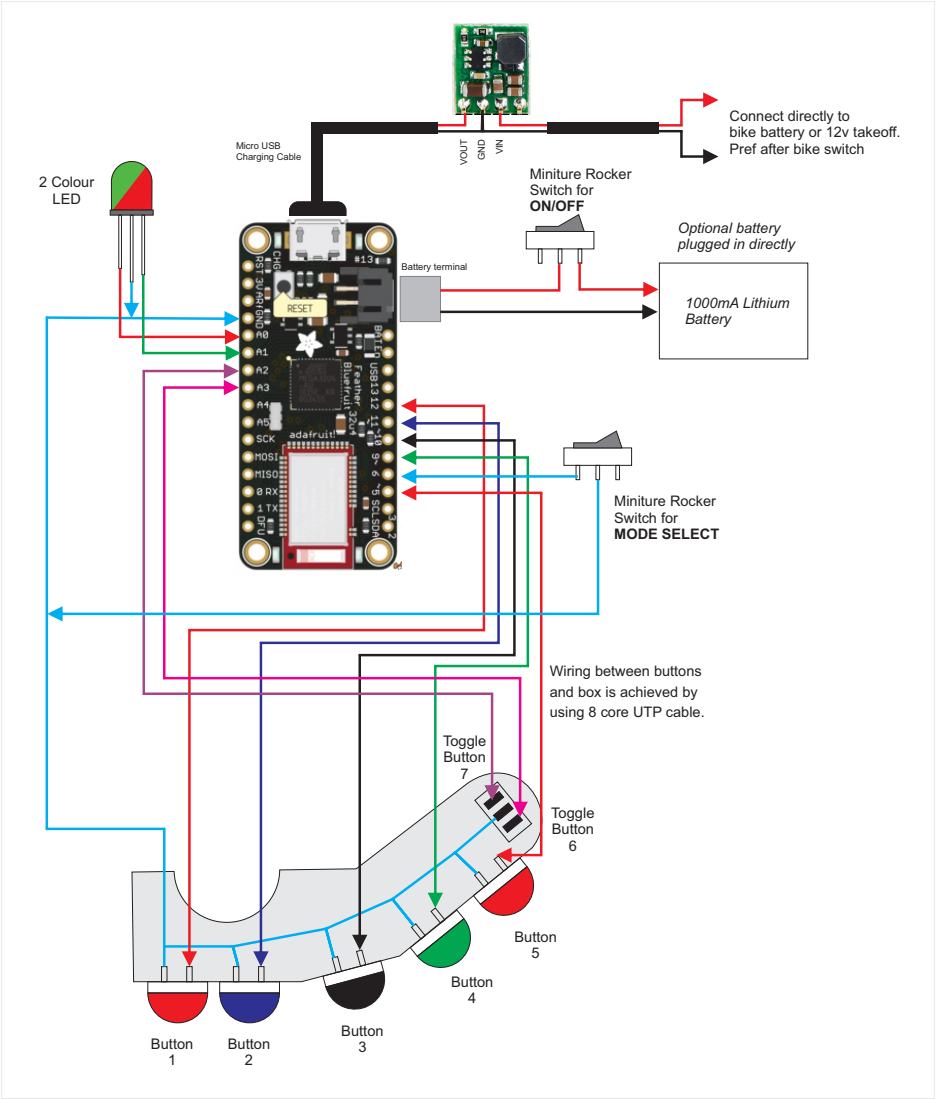
[picture p63: page 1]
Battery terminal; Button 1; Button 2; Button 3; Button 4; Button 5; Toggle Button 6; Toggle Button 7; 2 Colour LED; 1000mA Lithium Battery; Miniture Rocker Switch for MODE SELECT; VOUT; GND; VIN; Micro USB Charging Cable; Miniture Rocker Switch for ON/OFF

Connect directly to
bike battery or 12v takeoff.
Pref after bike switch

Optional battery
plugged in directly

Wiring between buttons
and box is achieved by
using 8 core UTP cable.
