eugeneworldwide/rampage_navigation_controller/Sticker designs v1.3 Box Design/Bluetooth box stickers for 1.7.pdf

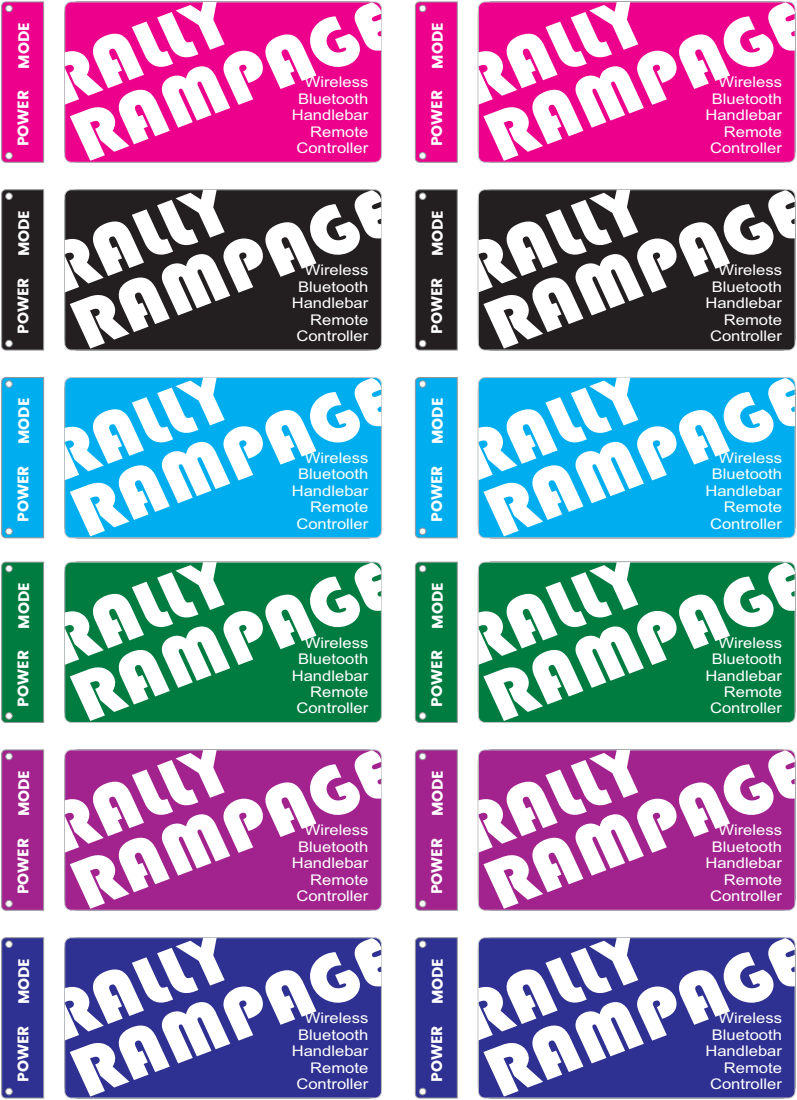
[picture p64: page 1]
Wireless Bluetooth Handlebar Remote Controller; POWER MODE
