eugeneworldwide/rampage_navigation_controller/Circuit Design with 3 power options/01 Rampage Navigator Circuit Design with battery.pdf

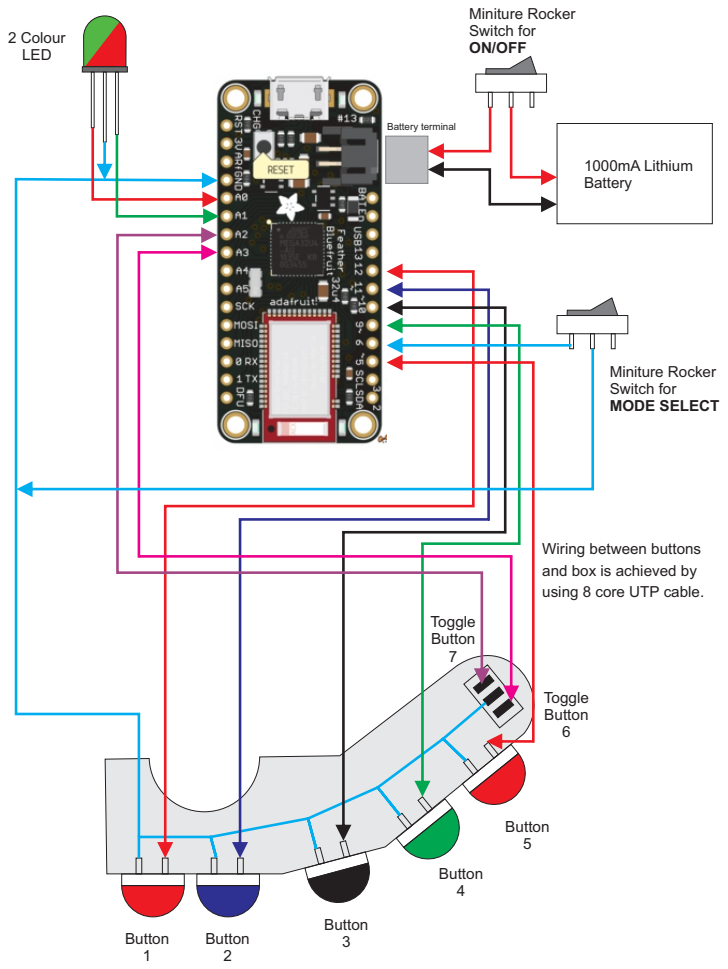
[picture p65: page 1]
Battery terminal; Button 1; Button 2; Button 3; Button 4; Button 5; Toggle Button 6; Toggle Button 7; 2 Colour LED; Miniture Rocker Switch for ON/OFF; 1000mA Lithium Battery; Miniture Rocker Switch for MODE SELECT

Wiring between buttons
and box is achieved by
using 8 core UTP cable.
