eugeneworldwide/rampage_navigation_controller/(commit log)

2021-10-12 Version 1.5
    This is an update to my internal version 1.5 from version 1.3
    [Bluetooth box 1.1 - Box.stl, Bluetooth box 1.1 - Lid.stl, Controller buttons 1.2.1 Solid one side - Back plate.stl, Controller buttons 1.2.1 Solid one side - Casing.stl, Controller buttons 1.2.1 Solid one side - lid.stl]
2021-10-13 Missing files
    Added STL files that were missing and fixed spelling and headings
    [Bluetooth box 1.1 - Box.stl, Bluetooth box 1.1 - Lid.stl, Bluetooth box 1.3 - Box.stl, Bluetooth box 1.3 - Lid.stl, Controller button 1.3 - Lid.stl, Controller button 1.3 - Part 3.stl, Controller buttons 1.2.1 Solid one side - Back plate.stl, Controller buttons 1.2.1 Solid one side - Casing.stl]
2021-10-13 Version 1.5
    Further file name updates
    [Bluetooth box 1.5 - Box.stl, Bluetooth box 1.5 - Lid.stl, Controller button 1.5 - Lid.stl, Controller button 1.5 - Part 3.stl]
2021-10-21 Version 1.5
    Updated STL files
    [Bluetooth box 1.5 - Box.stl, Bluetooth box 1.5 - Lid.stl, Controller button 1.5 - Back.stl, Controller button 1.5 - Lid.stl, Controller button 1.5 - Part 3.stl]
2021-12-14 Version 1.7
    This is a complete new code with new functionality.
    This version allows for up to 5 softApp key map options as well as accomodate for using normaly-closed or nomrally-open push buttons.
2023-06-27 v1.7.4.7
    Updated to version 1.7.4.7 with new comment and simpler functions. Still keeping code outlined for easy editing by novice DIY builders
    [Bluetooth box 1.5 - Box.stl, Bluetooth box 1.5 - Lid.stl, Bluetooth box 1.6 - Box.stl, Bluetooth box 1.6 - Lid.stl, Controller button 1.5 - Body.stl, Controller button 1.5 - Lid.stl, Controller button 1.6 - Back.stl, Controller button 1.6 - Body.stl]
